Andy-jg/HID-KEY2Bluekey/相关资料说明/HID蓝牙模块使用电路连接.png

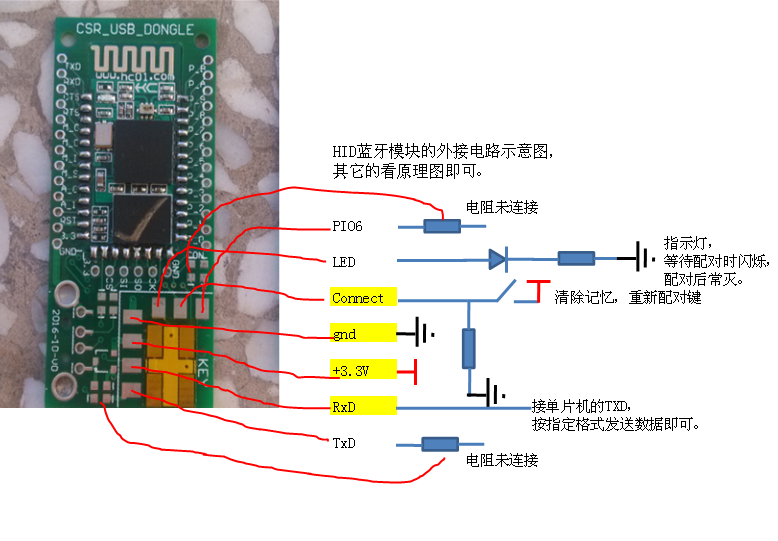
相关资料说明/HID蓝牙模块使用电路连接.png
