Andy-jg/HID-KEY2Bluekey/README.md

# HID-KEY2Bluetoothkey
hid-key tran to bluekey
Convert to HID signal with KEYBOARD
