Andy-jg/HID-KEY2Bluekey/相关资料说明/键盘码.xlsx

Sheet: 原始码
08 88 | 0 | 1 | 2 | 3 | 4 | 5 | 6 | 7 | 8 | 9 | 10 | 11 | 12 | 13
0E 8E 16 96 1E 9E 26 A6 25 A5 2E AE 36 B6 3D BD 3E BE 46 C6 45 C5 4E CE 55 D5 71 F1 | 0E 8E | 16 96 | 1E 9E | 26 A6 | 25 A5 | 2E AE | 36 B6 | 3D BD | 3E BE | 46 C6 | 45 C5 | 4E CE | 55 D5 | 71 F1
0D 8D 15 95 1D 9D 24 A4 2D AD 2C AC 35 B5 3C BC 43 C3 44 C4 4D CD 54 D4 5B DB 5D DD | 0D 8D | 15 95 | 1D 9D | 24 A4 | 2D AD | 2C AC | 35 B5 | 3C BC | 43 C3 | 44 C4 | 4D CD | 54 D4 | 5B DB | 5D DD
58 D8 1C 9C 1B 9B 23 A3 2B AB 34 B4 33 B3 3B BB 42 C2 4B CB 4C CC 52 D2 5A DA | 58 D8 | 1C 9C | 1B 9B | 23 A3 | 2B AB | 34 B4 | 33 B3 | 3B BB | 42 C2 | 4B CB | 4C CC | 52 D2 | 5A DA
12 92 1A 9A 22 A2 21 A1 2A AA 32 B2 31 B1 3A BA 41 C1 49 C9 28 A8 59 D9 4A CA | 12 92 | 1A 9A | 22 A2 | 21 A1 | 2A AA | 32 B2 | 31 B1 | 3A BA | 41 C1 | 49 C9 | 28 A8 | 59 D9 | 4A CA
14 94 02 82 07 87 10 90 5C DC 13 93 5E DE 60 E0 2F AF 66 E6 | 14 94 | 02 82 | 07 87 | 10 90 | 5C DC | 13 93 | 5E DE | 60 E0 | 2F AF | 66 E6
0E 8E 16 96 1E 9E 26 A6 25 A5 2E AE 36 B6 3D BD 3E BE 46 C6 45 C5 4E CE 55 D5 71 F1

Sheet: 解码
按下+抬起 | 08 88
字符 | ESC
按下+抬起 | 0E 8E | 16 96 | 1E 9E | 26 A6 | 25 A5 | 2E AE | 36 B6 | 3D BD | 3E BE | 46 C6 | 45 C5 | 4E CE | 55 D5 | 71 F1
第二字符 | ~ | ! | @ | # | $ | % | ^ | & | * | ( | ) | — | +
第一字符 | 、[ESC] | 1 | 2 | 3 | 4 | 5 | 6 | 7 | 8 | 9 | 0 | - | = | ←
按下+抬起 | 0D 8D | 15 95 | 1D 9D | 24 A4 | 2D AD | 2C AC | 35 B5 | 3C BC | 43 C3 | 44 C4 | 4D CD | 54 D4 | 5B DB | 5D DD
第二字符 | messege |  |  |  | table | paste | copy |  |  |  |  |  |  | ok
第一字符 | TAB | Q | W | E | R | T | Y | U | I | O | P | [ | ] | \
按下+抬起 | 58 D8 | 1C 9C | 1B 9B | 23 A3 | 2B AB | 34 B4 | 33 B3 | 3B BB | 42 C2 | 4B CB | 4C CC | 52 D2 | 5A DA
第二字符 |  | tel | clock |  | turnarraw
第一字符 | CAPS | A | S | D | F | G | H | J | K | L | ; | ' | ENTER
按下+抬起 | 12 92 |  | 1A 9A | 22 A2 | 21 A1 | 2A AA | 32 B2 | 31 B1 | 3A BA | 41 C1 | 49 C9 | 28 A8 | 59 D9 | 4A CA
第二字符 |  |  |  |  |  |  |  |  |  | < | > | pg up |  | ?batt
第一字符 | SHIIFT |  | Z | X | C | V | B | N | M | , | . | ↑ | SHIFT | /
按下+抬起 | 14 94 | 02 82 | 07 87 | 10 90 | 5C DC |  |  |  |  | 13 93 | 5E DE | 60 E0 | 2F AF | 66 E6
第二字符 |  |  |  |  |  |  |  |  |  |  | home | pg dn | end
第一字符 | CTRL | Fn | WIN | ALT | SPACE |  |  |  |  | ALT GR | ← | ↓ | → | DEL
