Andy-jg/HID-KEY2Bluekey/(list of files, cad)

Other CAD files:
UART接收HID发送soft/F330_UART.OBJ
