Andy-jg/HID-KEY2Bluekey/相关资料说明/pdf原理图.pdf

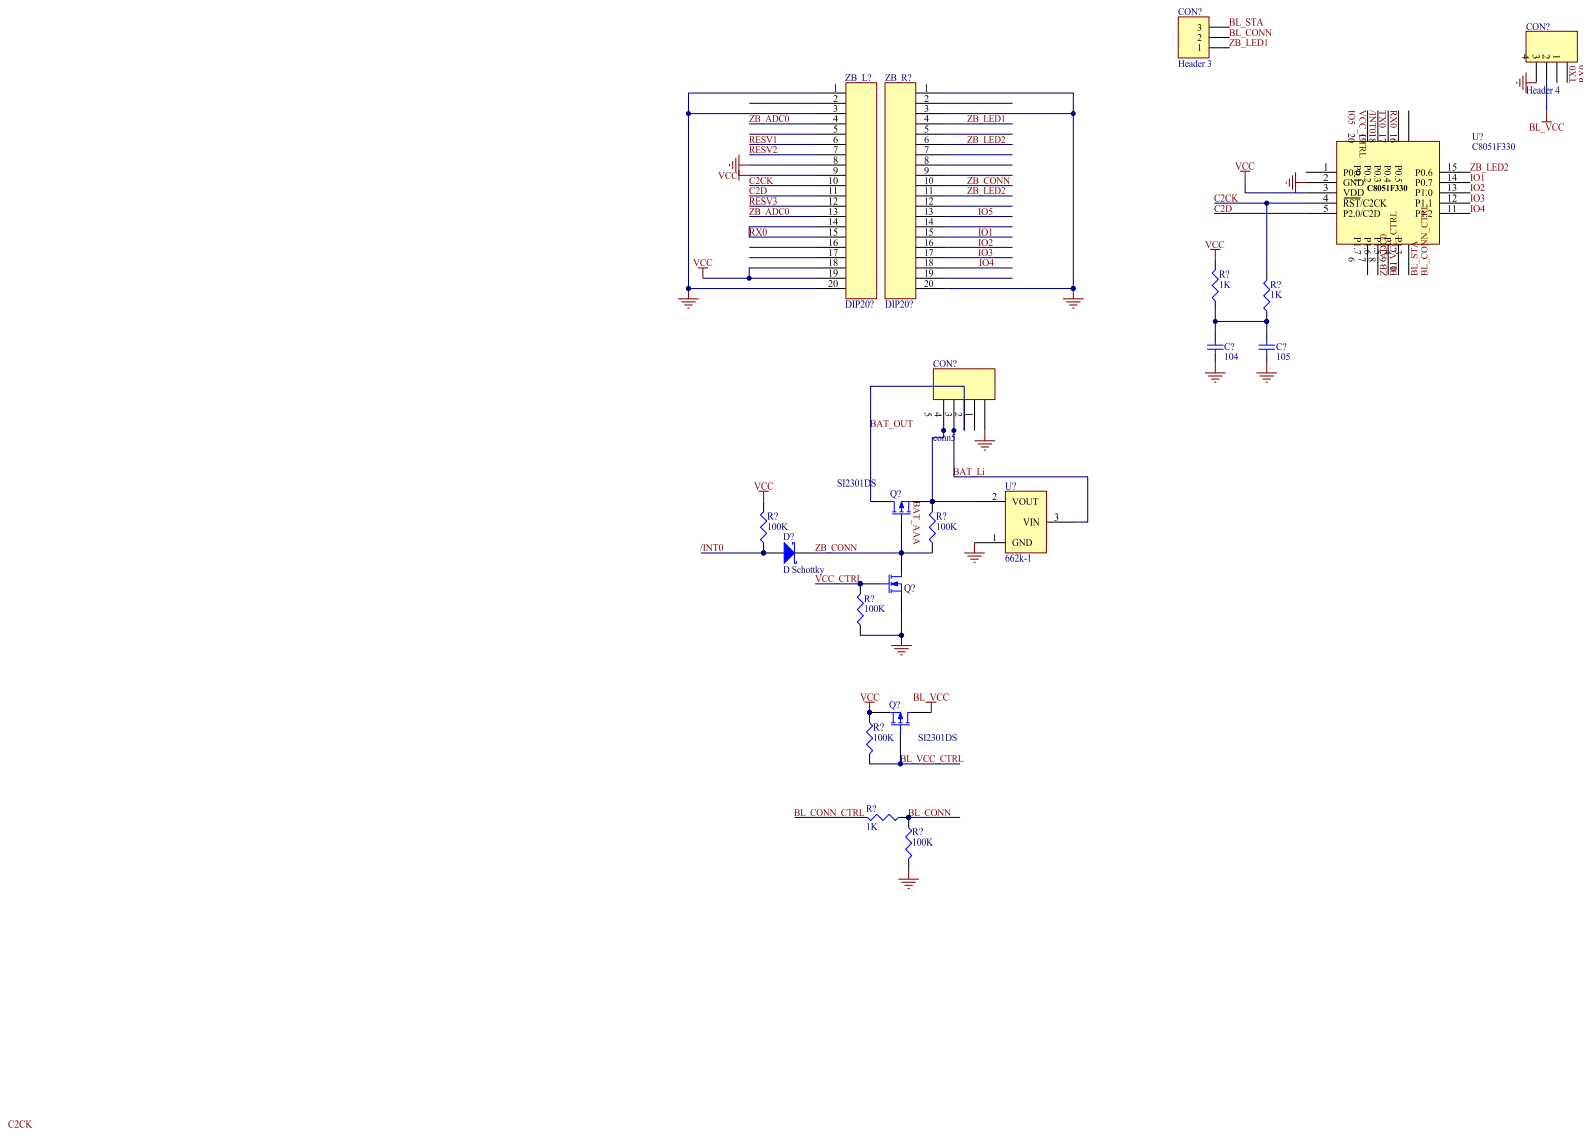
[picture p9: page 1]

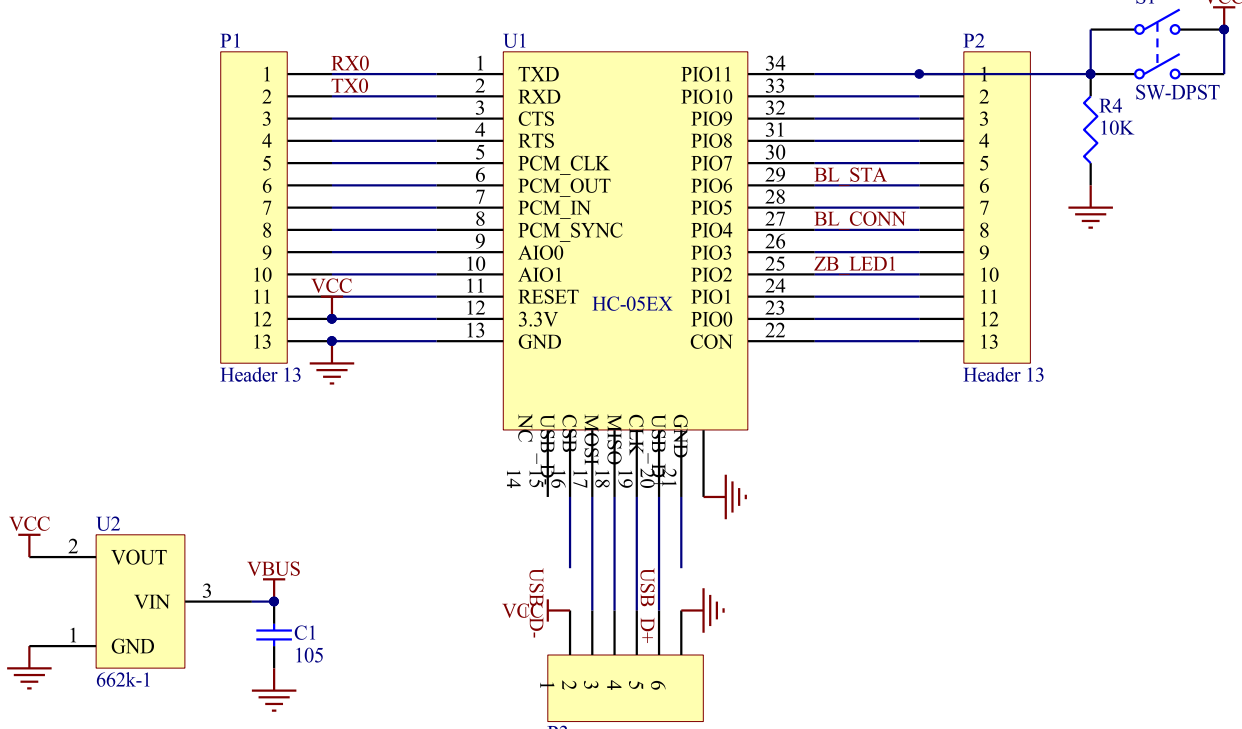
[picture p10: figure]
