Andy-jg/HID-KEY2Bluekey/UART接收HID发送soft/mytype.h

#ifndef __MYTYPE_H__
#define __MYTYPE_H__

#define uint8 unsigned char
#define uint16 unsigned short int
#define uint32 unsigned long int
#define int8 signed char
#define int16 signed short int
#define int32 signed long int
#define uint64 unsigned long long int
#define int64 signed long long int

#endif
