Andy-jg/HID-KEY2Bluekey/(commit log)

2018-10-08 初始化 UART2HID-sofT
    [F330_UART.OBJ]
2018-10-08 格式上更改。排版从新做。
2018-10-08 chang var name.work well nomal.
    [F330_UART.OBJ]
2018-10-08 add project content file
    [键盘码.xlsx]
2018-10-08 del .lst .obj. .bak file
    [F330_UART.OBJ]
2018-10-08 慢慢把内容分开。
2018-10-09 更改回来 原来 的状态。生成的代码一样。
2018-10-09 增加工程管理逻辑。
2018-10-09 分开。。把定义重新整理。
2018-10-09 自动重新排版。
2018-10-13 更改软件中不相关的表示。方便 查看。
2018-10-13 方便查看 。
2018-10-13 准备做一个分支，做TAIL HEAL.操作。
2018-10-13 // uart send a byte and will set the flag.
2018-10-13 这个理论上也可以正常工作。
